Ealdin/keyboards/Quadrant/readme.md

# Quadrant

Quadrant

The Quadrant E-C is a 5x14 ortholinear keyboard, featuring through-hole components, a fancy two-sided bottom plate with different graphics and options for rotary encoder and WS2818B LED stripes and it supports both MX, Alps and Kailh Choc style switches.

*Note: The picture above shows an earlier prototype of the Quadrant using Teensy 2.0*
