Ealdin/keyboards/Quadrant/accessories/readme.md

# Accessories for Quadrant

You can find here files of accessories, like 3mm polycarbonate shield and switch plates (these plates can be used only without the case).
