Ealdin/keyboards/Quadrant/images/acrylic_layered_case_exploded.jpg

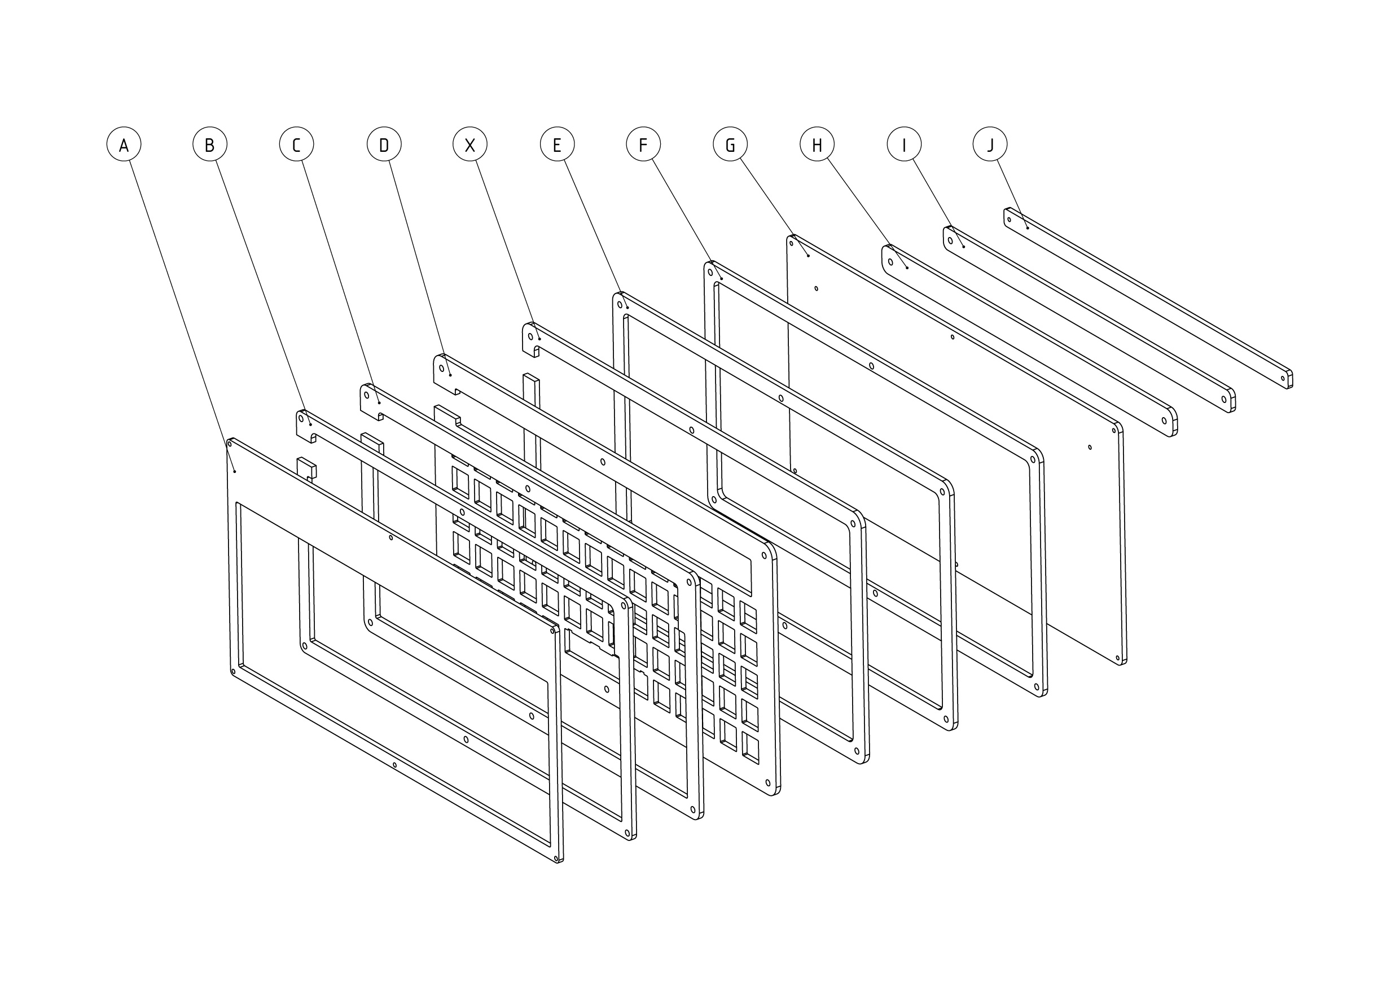
Quadrant/images/acrylic_layered_case_exploded.jpg
