Ealdin/keyboards/(list of files, cad)

Other CAD files:
Quadrant/accessories/cover_plate.DWG
