Ealdin/keyboards/Quadrant/firmware/quadrant/config.h

/*
Copyright 2021 Ealdin Keyboards
This program is free software: you can redistribute it and/or modify
it under the terms of the GNU General Public License as published by
the Free Software Foundation, either version 2 of the License, or
(at your option) any later version.
This program is distributed in the hope that it will be useful,
but WITHOUT ANY WARRANTY; without even the implied warranty of
MERCHANTABILITY or FITNESS FOR A PARTICULAR PURPOSE.  See the
GNU General Public License for more details.
You should have received a copy of the GNU General Public License
along with this program.  If not, see <http://www.gnu.org/licenses/>.
*/

#pragma once

#include "config_common.h"

/* USB Device descriptor parameter */
#define VENDOR_ID       0x0192   // Ealdin Keyboards "ƒ"
#define PRODUCT_ID      0x5154   // Quadrant "QT"
#define DEVICE_VER      0x0001
#define MANUFACTURER    Ealdin
#define PRODUCT         Quadrant E-C
#define DESCRIPTION     A 5x14 ortholinear keyboard

/* key matrix size */
#define MATRIX_ROWS 5
#define MATRIX_COLS 14

#define MATRIX_ROW_PINS { B2, F7, B3, B6, B1 }
#define MATRIX_COL_PINS { D3, D2, D1, D0, D4, C6, D7, E6, B4, B5, B7, F6, F5, F4 }
#define UNUSED_PINS

/* COL2ROW, ROW2COL*/
#define DIODE_DIRECTION COL2ROW

#define ENCODER_DIRECTION_FLIP
#define ENCODERS_PAD_A { F1 }
#define ENCODERS_PAD_B { D5 }
#define ENCODER_RESOLUTION 4

#define LED_CAPS_LOCK_PIN B0
#define RGB_DI_PIN C7
#ifdef RGB_DI_PIN
   #define RGBLED_NUM 7
   #define RGBLIGHT_HUE_STEP 8
   #define RGBLIGHT_SAT_STEP 8
   #define RGBLIGHT_VAL_STEP 8
   #define RGBLIGHT_LIMIT_VAL 255 /* The maximum brightness level */
   #define RGBLIGHT_SLEEP  /* If defined, the RGB lighting will be switched off when the host goes to sleep */
    /*== all animations enable ==*/
   #define RGBLIGHT_ANIMATIONS
// /*== or choose animations ==*/
//   #define RGBLIGHT_EFFECT_BREATHING
//   #define RGBLIGHT_EFFECT_RAINBOW_MOOD
//   #define RGBLIGHT_EFFECT_RAINBOW_SWIRL
//   #define RGBLIGHT_EFFECT_SNAKE
//   #define RGBLIGHT_EFFECT_KNIGHT
//   #define RGBLIGHT_EFFECT_CHRISTMAS
//   #define RGBLIGHT_EFFECT_STATIC_GRADIENT
//   #define RGBLIGHT_EFFECT_RGB_TEST
//   #define RGBLIGHT_EFFECT_ALTERNATING
// /*== customize breathing effect ==*/
//   /*==== (DEFAULT) use fixed table instead of exp() and sin() ====*/
//   #define RGBLIGHT_BREATHE_TABLE_SIZE 256      // 256(default) or 128 or 64
//   /*==== use exp() and sin() ====*/
//   #define RGBLIGHT_EFFECT_BREATHE_CENTER 1.85  // 1 to 2.7
//   #define RGBLIGHT_EFFECT_BREATHE_MAX    255   // 0 to 255
#endif

/* Debounce reduces chatter (unintended double-presses) - set 0 if debouncing is not needed */
#define DEBOUNCE 5

/* define if matrix has ghost (lacks anti-ghosting diodes) */
//#define MATRIX_HAS_GHOST

/* Mechanical locking support. Use KC_LCAP, KC_LNUM or KC_LSCR instead in keymap */
#define LOCKING_SUPPORT_ENABLE
/* Locking resynchronize hack */
#define LOCKING_RESYNC_ENABLE

/* If defined, GRAVE_ESC will always act as ESC when CTRL is held.
 * This is userful for the Windows task manager shortcut (ctrl+shift+esc).
 */
// #define GRAVE_ESC_CTRL_OVERRIDE

/*
 * Feature disable options
 *  These options are also useful to firmware size reduction.
 */

/* disable debug print */
//#define NO_DEBUG

/* disable print */
//#define NO_PRINT

/* disable action features */
//#define NO_ACTION_LAYER
//#define NO_ACTION_TAPPING
#define NO_ACTION_ONESHOT
#define NO_ACTION_MACRO
//#define NO_ACTION_FUNCTION
