Ealdin/keyboards/(commit log)

2020-11-23 Update case files for Round2
2021-01-29 Tweaked D1 and D2 layers
    Tweaked D1 and D2 layers to be fully compatible with encoders and screw-in stabilizers.
2021-02-01 Update config.h to eliminate the encoder bug
    Kudos to u/nuno99costa
    [config.h]
